parkourlrc/pcb-aprskalo1--nano24-elrs-receiver-8cf431871f/exports/schematic/ELRS-Receiver.png

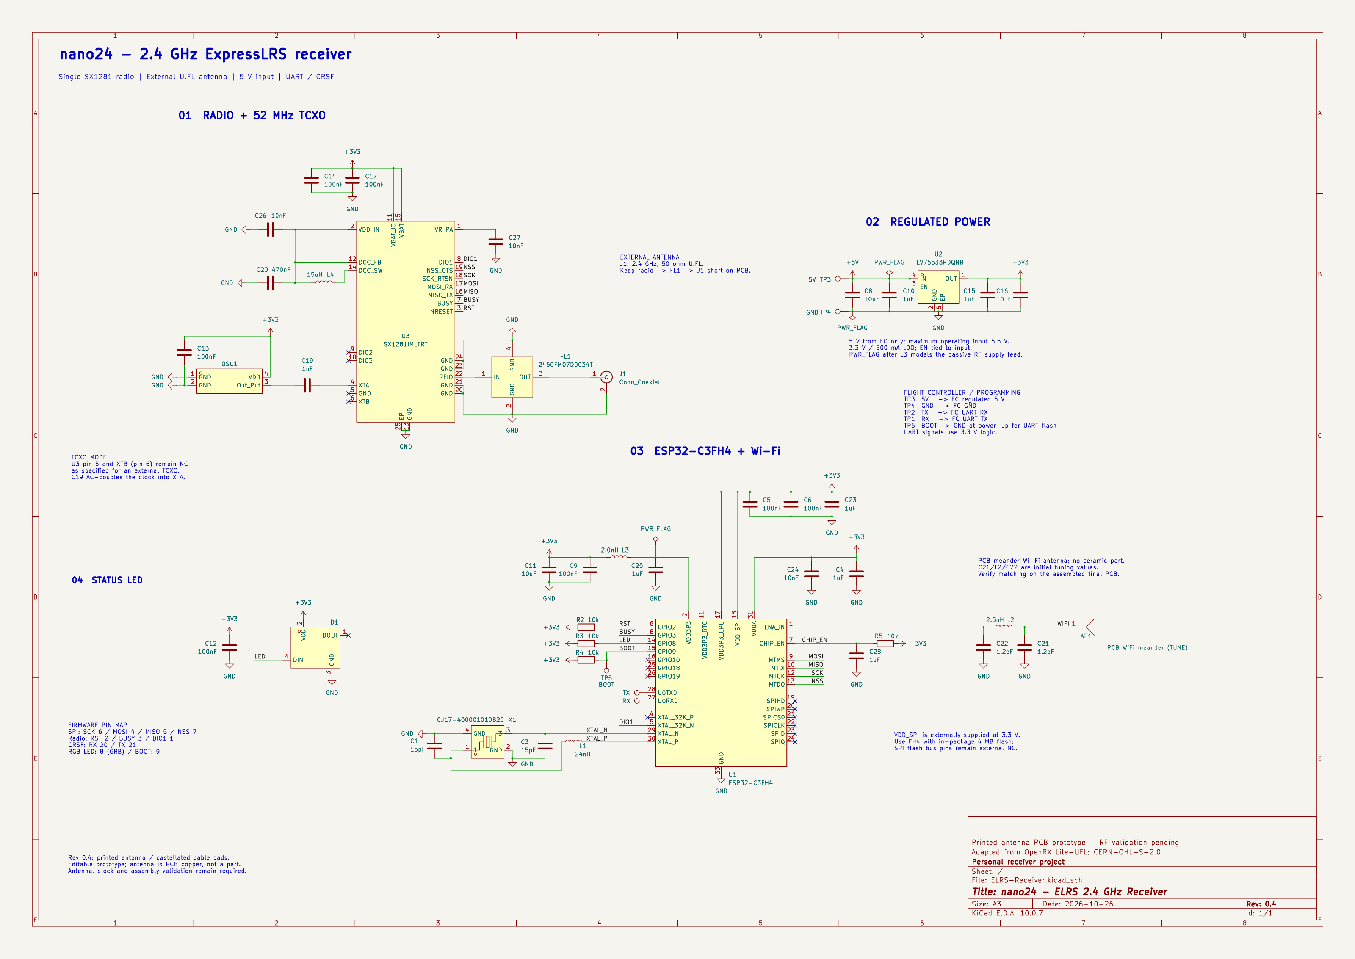
exports/schematic/ELRS-Receiver.png
