parkourlrc/pcb-aprskalo1--nano24-elrs-receiver-8cf431871f/exports/ELRS-Receiver-BOM.csv

Designator | Value | MPN | Manufacturer | LCSC | Footprint | Quantity | TuningNote
C1 | 15pF | GRM0335C1H150JA01D | muRata | C85891 | RX_V04:C1_v04 | 1
C3 | 15pF | GRM0335C1H150JA01D | muRata | C85891 | RX_V04:C3_v04 | 1
C4 | 1uF | GRM033R61A105ME44D | muRata | C76935 | RX_Compact:C_0201_0603Metric_C4 | 1
C5 | 100nF | GRM033R61E104KE14D | muRata | C76939 | RX_Compact:C_0201_0603Metric_C5 | 1
C6 | 100nF | GRM033R61E104KE14D | muRata | C76939 | RX_Compact:C_0201_0603Metric_C6 | 1
C8 | 10uF | CL05A106MQ5NUNC | Samsung Electro-Mechanics | C15525 | RX_Compact:C_0402_1005Metric_C8 | 1
C9 | 100nF | GRM033R61E104KE14D | muRata | C76939 | RX_Compact:C_0201_0603Metric_C9 | 1
C10 | 1uF | GRM033R61A105ME44D | muRata | C76935 | RX_Compact:C_0201_0603Metric_C10 | 1
C11 | 10uF | GRM155R60J106ME44D | muRata | C76991 | RX_Compact:C_0402_1005Metric_C11 | 1
C12 | 100nF | GRM033R61E104KE14D | muRata | C76939 | RX_Compact:C_0201_0603Metric_C12 | 1
C13 | 100nF | GRM033R61E104KE14D | muRata | C76939 | RX_Compact:C_0201_0603Metric_C13 | 1
C14 | 100nF | GRM033R61E104KE14D | muRata | C76939 | RX_Compact:C_0201_0603Metric_C14 | 1
C15 | 1uF | GRM033R61A105ME44D | muRata | C76935 | RX_Compact:C_0201_0603Metric_C15 | 1
C16 | 10uF | CL05A106MQ5NUNC | Samsung Electro-Mechanics | C15525 | RX_Compact:C_0402_1005Metric_C16 | 1
C17 | 100nF | GRM033R61E104KE14D | muRata | C76939 | RX_Compact:C_0201_0603Metric_C17 | 1
C19 | 1nF | 0201B102K500NT | FH | C66942 | RX_Compact:C_0201_0603Metric_C19 | 1
C20 | 470nF | GRM033R60J474KE90D | muRata | C85926 | RX_Compact:C_0201_0603Metric_C20 | 1
C21 | 1.2pF | GRM0335C1H1R2BA01D | muRata | C85895 | RX_V04:C21_v04 | 1 | Initial population only; retune for printed antenna on assembled board
C22 | 1.2pF | GRM0335C1H1R2BA01D | muRata | C85895 | RX_V04:C22_v04 | 1 | Initial population only; retune for printed antenna on assembled board
C23 | 1uF | GRM033R61A105ME44D | muRata | C76935 | RX_Compact:C_0201_0603Metric_C23 | 1
C24 | 10nF | GRM033R61A103KA01J | muRata | C2168164 | RX_Compact:C_0201_0603Metric_C24 | 1
C25 | 1uF | GRM033R61A105ME44D | muRata | C76935 | RX_Compact:C_0201_0603Metric_C25 | 1
C26 | 10nF | GRM033R61A103KA01J | muRata | C2168164 | RX_Compact:C_0201_0603Metric_C26 | 1
C27 | 10nF | GRM033R61A103KA01J | muRata | C2168164 | RX_Compact:C_0201_0603Metric_C27 | 1
C28 | 1uF | GRM033R61A105ME44D | muRata | C76935 | RX_V04:C28_v04 | 1
D1 | XL-1010RGBC-WS2812B | XL-1010RGBC-2812B | XINGLIGHT | C5349953 | RX_Compact:LED-SMD_4P-L1.0-W1.0-TL_XL-1010RGBC-WS2812B_D1 | 1
FL1 | 2450FM07D0034T | 2450FM07D0034T | JOHANSON(约翰逊) | C2651081 | RX_Compact:FILTER-SMD_4P-L1.0-W0.5-L_FL1 | 1
J1 | Conn_Coaxial | U.FL-R-SMT-1(80) | HRS | C88374 | RX_Compact:U.FL_Hirose_U.FL-R-SMT-1_Vertical_J1 | 1
L1 | 24nH | LQP03TN24NH02D | muRata | C206441 | RX_V04:L1_v04 | 1
L2 | 2.5nH | LQP03TN2N5C02D | muRata | C206435 | RX_V04:L2_v04 | 1 | Initial population only; retune for printed antenna on assembled board
L3 | 2.0nH | LQP03TN2N0B02D | muRata | C86125 | RX_Compact:L_0201_0603Metric_L3 | 1
L4 | 15uH | MLZ2012M150WT000 | Murata Electronics | C383402 | RX_Compact:L_0805_2012Metric_L4 | 1
OSC1 | OW7EL89CENUNFAYLC-52M | OW7EL89CENUNFAYLC-52M | YXC Crystal Oscillators | C22434896 | RX_Compact:OSC-SMD_4P-L2.0-W1.6-BL_TXC_7Z_OSC1 | 1
R2 | 10k | RC0201FR-0710KL | YAGEO | C106225 | RX_Compact:R_0201_0603Metric_R2 | 1
R3 | 10k | RC0201FR-0710KL | YAGEO | C106225 | RX_Compact:R_0201_0603Metric_R3 | 1
R4 | 10k | RC0201FR-0710KL | YAGEO | C106225 | RX_Compact:R_0201_0603Metric_R4 | 1
R5 | 10k | RC0201FR-0710KL | YAGEO | C106225 | RX_V04:R5_v04 | 1
U1 | ESP32-C3FH4 | ESP32-C3FH4 | Espressif Systems | C2858491 | RX_Compact:ESP32C3_QFN32_EP3.7_U1 | 1
U2 | TLV75533PDQNR | TLV75533PDQNR | TI | C2861882 | RX_Compact:X2SON-4_L1.0-W1.0-P0.65-TL-EP_U2 | 1
U3 | SX1281IMLTRT | SX1281IMLTRT | SEMTECH | C2151551 | RX_Compact:QFN-24_L4.0-W4.0-P0.50-TL-EP2.6_U3 | 1
X1 | CJ17-400001010B20 | CJ17-400001010B20 | JSCJ | C2875272 | RX_V04:X1_v04 | 1
