parkourlrc/pcb-aprskalo1--nano24-elrs-receiver-8cf431871f/ELRS-Receiver.kicad_pcb

## KiCad design ELRS-Receiver.kicad_pcb (2026-10-26)

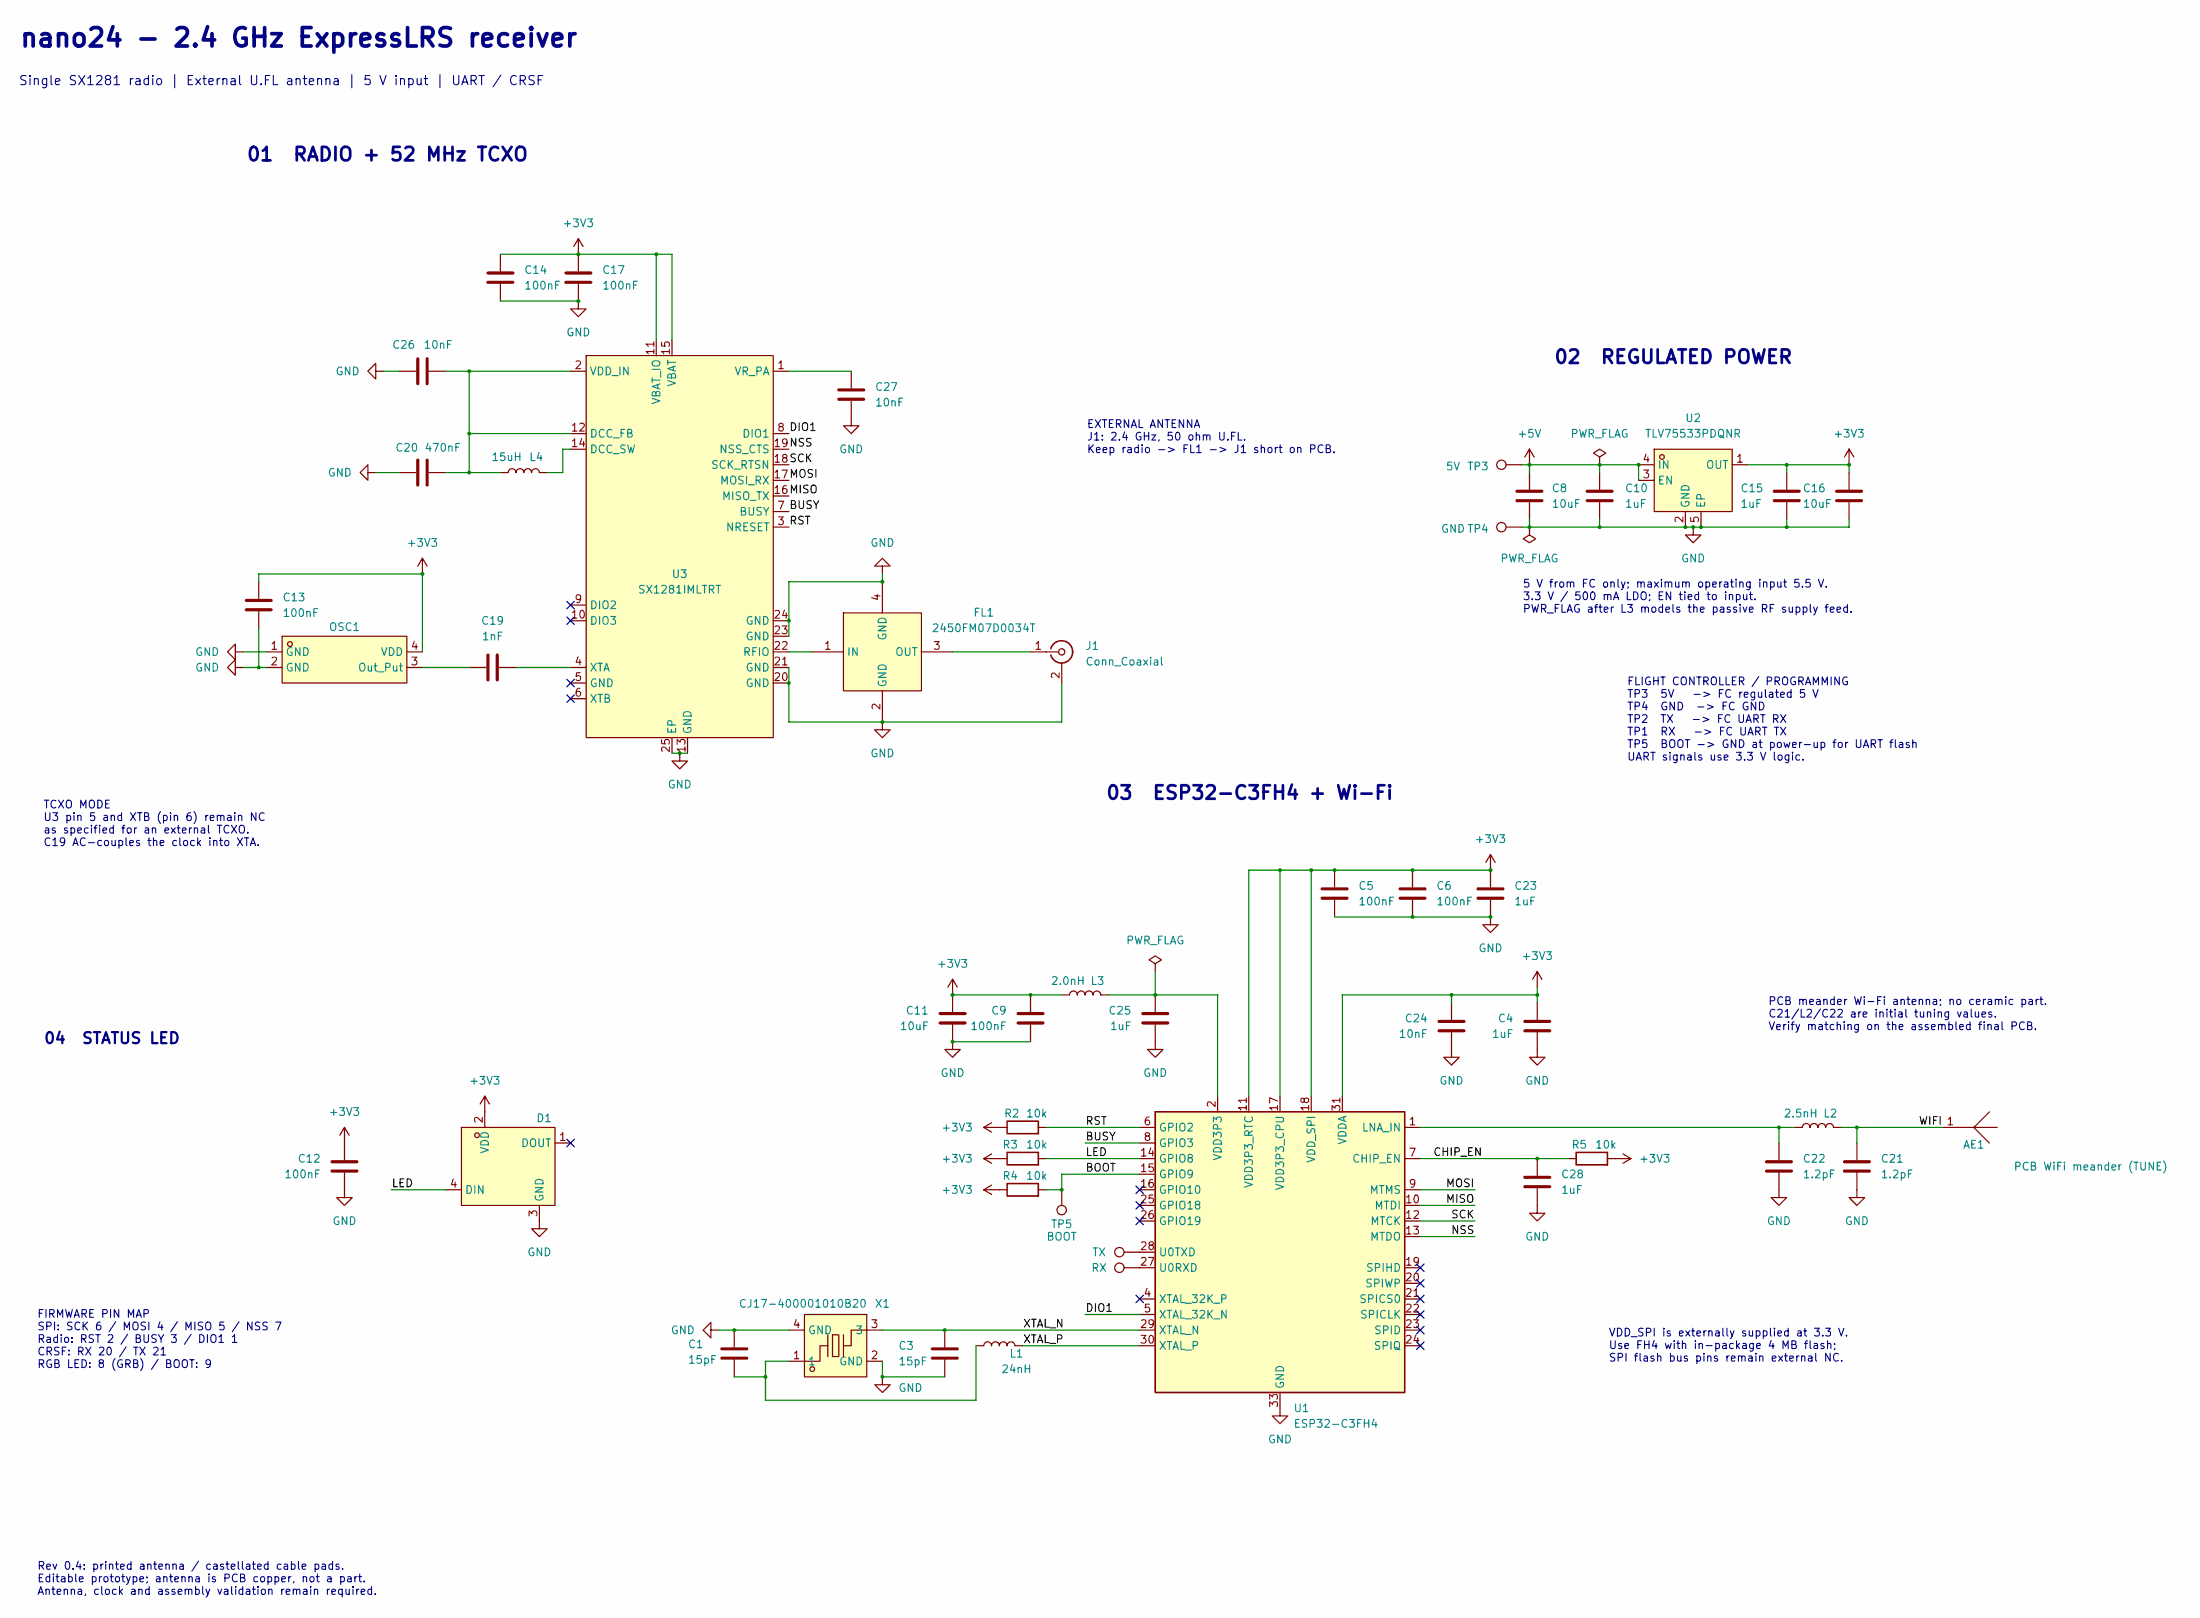
[picture p5: schematic ELRS-Receiver.kicad_sch, nano24 - ELRS 2.4 GHz Receiver]

Parts:
AE1: PCB WiFi meander (TUNE); PCB_Meander_2G4_v04; MPN PCB_FEATURE
C1: 15pF; C1_v04; MPN GRM0335C1H150JA01D; LCSC C85891
C3: 15pF; C3_v04; MPN GRM0335C1H150JA01D; LCSC C85891
C4: 1uF; C_0201_0603Metric_C4; MPN GRM033R61A105ME44D; LCSC C76935
C5: 100nF; C_0201_0603Metric_C5; MPN GRM033R61E104KE14D; LCSC C76939
C6: 100nF; C_0201_0603Metric_C6; MPN GRM033R61E104KE14D; LCSC C76939
C8: 10uF; C_0402_1005Metric_C8; MPN CL05A106MQ5NUNC; LCSC C15525
C9: 100nF; C_0201_0603Metric_C9; MPN GRM033R61E104KE14D; LCSC C76939
C10: 1uF; C_0201_0603Metric_C10; MPN GRM033R61A105ME44D; LCSC C76935
C11: 10uF; C_0402_1005Metric_C11; MPN GRM155R60J106ME44D; LCSC C76991
C12: 100nF; C_0201_0603Metric_C12; MPN GRM033R61E104KE14D; LCSC C76939
C13: 100nF; C_0201_0603Metric_C13; MPN GRM033R61E104KE14D; LCSC C76939
C14: 100nF; C_0201_0603Metric_C14; MPN GRM033R61E104KE14D; LCSC C76939
C15: 1uF; C_0201_0603Metric_C15; MPN GRM033R61A105ME44D; LCSC C76935
C16: 10uF; C_0402_1005Metric_C16; MPN CL05A106MQ5NUNC; LCSC C15525
C17: 100nF; C_0201_0603Metric_C17; MPN GRM033R61E104KE14D; LCSC C76939
C19: 1nF; C_0201_0603Metric_C19; MPN 0201B102K500NT; LCSC C66942
C20: 470nF; C_0201_0603Metric_C20; MPN GRM033R60J474KE90D; LCSC C85926
C21: 1.2pF; C21_v04; MPN GRM0335C1H1R2BA01D; LCSC C85895
C22: 1.2pF; C22_v04; MPN GRM0335C1H1R2BA01D; LCSC C85895
C23: 1uF; C_0201_0603Metric_C23; MPN GRM033R61A105ME44D; LCSC C76935
C24: 10nF; C_0201_0603Metric_C24; MPN GRM033R61A103KA01J; LCSC C2168164
C25: 1uF; C_0201_0603Metric_C25; MPN GRM033R61A105ME44D; LCSC C76935
C26: 10nF; C_0201_0603Metric_C26; MPN GRM033R61A103KA01J; LCSC C2168164
C27: 10nF; C_0201_0603Metric_C27; MPN GRM033R61A103KA01J; LCSC C2168164
C28: 1uF; C28_v04; MPN GRM033R61A105ME44D; LCSC C76935
D1: XL-1010RGBC-WS2812B; LED-SMD_4P-L1.0-W1.0-TL_XL-1010RGBC-WS2812B_D1; MPN XL-1010RGBC-2812B; LCSC C5349953
FL1: 2450FM07D0034T; FILTER-SMD_4P-L1.0-W0.5-L_FL1; MPN 2450FM07D0034T; LCSC Part_1 C2651081
J1: Conn_Coaxial; U.FL_Hirose_U.FL-R-SMT-1_Vertical_J1; MPN U.FL-R-SMT-1(80); LCSC C88374
L1: 24nH; L1_v04; MPN LQP03TN24NH02D; LCSC C206441
L2: 2.5nH; L2_v04; MPN LQP03TN2N5C02D; LCSC C206435
L3: 2.0nH; L_0201_0603Metric_L3; MPN LQP03TN2N0B02D; LCSC C86125
L4: 15uH; L_0805_2012Metric_L4; MPN MLZ2012M150WT000; LCSC C383402
OSC1: OW7EL89CENUNFAYLC-52M; OSC-SMD_4P-L2.0-W1.6-BL_TXC_7Z_OSC1; MPN OW7EL89CENUNFAYLC-52M; LCSC Part C22434896
R2: 10k; R_0201_0603Metric_R2; MPN RC0201FR-0710KL; LCSC C106225
R3: 10k; R_0201_0603Metric_R3; MPN RC0201FR-0710KL; LCSC C106225
R4: 10k; R_0201_0603Metric_R4; MPN RC0201FR-0710KL; LCSC C106225
R5: 10k; R5_v04; MPN RC0201FR-0710KL; LCSC C106225
TP1: RX; Castellated_WirePad_v04
TP2: TX; Castellated_WirePad_v04
TP3: 5V; Castellated_WirePad_v04
TP4: GND; Castellated_WirePad_v04
TP5: BOOT; BootPad_Front_v04
U1: ESP32-C3FH4; ESP32C3_QFN32_EP3.7_U1; MPN ESP32-C3FH4; LCSC C2858491
U2: TLV75533PDQNR; X2SON-4_L1.0-W1.0-P0.65-TL-EP_U2; MPN TLV75533PDQNR; LCSC Part C2861882
U3: SX1281IMLTRT; QFN-24_L4.0-W4.0-P0.50-TL-EP2.6_U3; MPN SX1281IMLTRT; LCSC Part C2151551
X1: CJ17-400001010B20; X1_v04; MPN CJ17-400001010B20; LCSC Part C2875272

Connections:
+3V3: C4.1, C5.1, C6.1, C9.1, C11.1, C12.1, C13.1, C14.1, C15.1, C16.1, C17.1, C23.1, C24.1, D1.2 (VDD), L3.2, OSC1.4 (VDD), R2.1, R3.1, R4.1, R5.2, U1.11 (VDD3P3_RTC), U1.17 (VDD3P3_CPU), U1.18 (VDD_SPI), U1.31 (VDDA), U1.32 (VDDA), U2.1 (OUT), U3.11 (VBAT_IO), U3.15 (VBAT)
+5V: C8.1, C10.1, TP3.1, U2.3 (EN), U2.4 (IN)
/BOOT: R4.2, TP5.1, U1.15 (GPIO9)
/BUSY: U1.8 (GPIO3), U3.7 (BUSY)
/CHIP_EN: C28.1, R5.1, U1.7 (CHIP_EN)
/DIO1: U1.5 (XTAL_32K_N), U3.8 (DIO1)
/LED: D1.4 (DIN), R3.2, U1.14 (GPIO8)
/MISO: U1.10 (MTDI), U3.16 (MISO_TX)
/MOSI: U1.9 (MTMS), U3.17 (MOSI_RX)
/NSS: U1.13 (MTDO), U3.19 (NSS_CTS)
/RST: R2.2, U1.6 (GPIO2), U3.3 (NRESET)
/SCK: U1.12 (MTCK), U3.18 (SCK_RTSN)
/WIFI: AE1.1, C21.1, L2.1
/XTAL_N: C3.1, U1.29 (XTAL_N), X1.3
/XTAL_P: L1.2, U1.30 (XTAL_P)
GND: C1.2, C3.2, C4.2, C5.2, C6.2, C8.2, C9.2, C10.2, C11.2, C12.2, C13.2, C14.2, C15.2, C16.2, C17.2, C20.1, C21.2, C22.2, C23.2, C24.2, C25.2, C26.1, C27.2, C28.2, D1.3 (GND), FL1.2 (GND), FL1.4 (GND), J1.2 (Ext), OSC1.1 (GND), OSC1.2 (GND), TP4.1, U1.33 (GND), U2.2 (GND), U2.5 (EP), U3.13 (GND), U3.20 (GND), U3.21 (GND), U3.23 (GND), U3.24 (GND), U3.25 (EP), X1.2 (GND), X1.4 (GND)
unnamed: C1.1, L1.1, X1.1
unnamed: C25.1, L3.1, U1.2 (VDD3P3), U1.3 (VDD3P3)
unnamed: FL1.1 (IN), U3.22 (RFIO)
unnamed: FL1.3 (OUT), J1.1 (In)
unnamed: C19.1, OSC1.3 (Out_Put)
unnamed: C22.1, L2.2, U1.1 (LNA_IN)
unnamed: TP1.1, U1.27 (U0RXD)
unnamed: TP2.1, U1.28 (U0TXD)
unnamed: C20.2, C26.2, L4.1, U3.2 (VDD_IN), U3.12 (DCC_FB)
unnamed: L4.2, U3.14 (DCC_SW)
unnamed: C27.1, U3.1 (VR_PA)
unnamed: C19.2, U3.4 (XTA)

Notes on the sheet:
nano24 - 2.4 GHz ExpressLRS receiver
Single SX1281 radio | External U.FL antenna | 5 V input | UART / CRSF
01 RADIO + 52 MHz TCXO
02 REGULATED POWER
5 V from FC only; maximum operating input 5.5 V. 3.3 V / 500 mA LDO; EN tied to input. PWR_FLAG after L3 models the passive RF supply feed.
03 ESP32-C3FH4 + Wi-Fi
04 STATUS LED
EXTERNAL ANTENNA J1: 2.4 GHz, 50 ohm U.FL. Keep radio -> FL1 -> J1 short on PCB.
TCXO MODE U3 pin 5 and XTB (pin 6) remain NC as specified for an external TCXO. C19 AC-couples the clock into XTA.
FLIGHT CONTROLLER / PROGRAMMING TP3 5V -> FC regulated 5 V TP4 GND -> FC GND TP2 TX -> FC UART RX TP1 RX -> FC UART TX TP5 BOOT -> GND at power-up for UART flash UART signals use 3.3 V logic.
PCB meander Wi-Fi antenna; no ceramic part. C21/L2/C22 are initial tuning values. Verify matching on the assembled final PCB.
VDD_SPI is externally supplied at 3.3 V. Use FH4 with in-package 4 MB flash; SPI flash bus pins remain external NC.
FIRMWARE PIN MAP SPI: SCK 6 / MOSI 4 / MISO 5 / NSS 7 Radio: RST 2 / BUSY 3 / DIO1 1 CRSF: RX 20 / TX 21 RGB LED: 8 (GRB) / BOOT: 9
Rev 0.4: printed antenna / castellated cable pads. Editable prototype; antenna is PCB copper, not a part. Antenna, clock and assembly validation remain required.

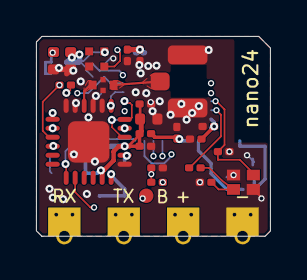
[picture p6: board ELRS-Receiver.kicad_pcb from above]

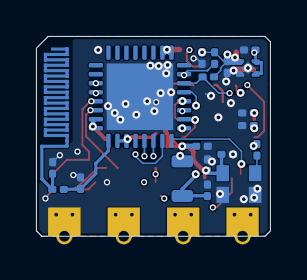
[picture p7: board ELRS-Receiver.kicad_pcb from below]

Board: 6 copper layers, 13.0 x 11.1 mm, 47 parts (20 on the bottom side), 28 nets.
